robinob/modbus-environment-sensor/manufacturing/BOM.csv

Viide | Komponent | Väärtus/Tüüp | Part number (näide) | Tootja | Kogus | Pakend | Märkused
U4 | Mikrokontroller | STM32G031F8P6 | STM32G031F8P6 | STMicroelectronics | 1 | TSSOP20 | UUS VIIDE (oli U1) - vastavalt 22.09.2026 KiCad-ekspordile. 20-jalaga; gull-wing jalad käsitsi joodetavad (0.65mm samm)
U2 | RS-485 transiiver | 5V half-duplex, autodirection | MAX13487EESA+ | Maxim/Analog Devices | 1 | SOIC-8 | Viide muutumatu (U2). VCC=5V otse U5 buck väljundilt; RE->5V (püsivalt kõrge), SHDN->5V (püsivalt sees); DI<-MCU otse; RO->MCU läbi R24/R25 pingejaoturi (vt allpool, uued viited)
U3 | Temperatuur/niiskusandur (bare kiip, ANDURIPLOKI plaadil) | I2C | SHT45-AD1F-R2 | Sensirion | 1 | DFN-4 | Viide muutumatu (U3). Täpsustatud osanumber KiCad-ekspordist: -R2 (tootja rull/pakendi kood) - sama kiip mis varem, ainult pakendi-suffix täpsustatud; ±1% RH / ±0.2°C
U1 | Õhukvaliteedi andur (eCO2/TVOC, bare kiip, ANDURIPLOKI plaadil) | I2C digitaalne gaasiandur | ENS160-BGLM | ScioSense | 1 | LGA-9 (3x3mm) | UUS VIIDE (oli U4). CSn PEAB olema joodetud otse VDDIO külge (I2C valik); ADDR joodetud GND (0x52) või VDDIO (0x53) külge; INTn jäetakse ühendamata (vt allpool, disabled firmware's), poll DEVICE_STATUS I2C kaudu
U6 | 1.8V LDO (ENS160 VDD, uus tuum-toiteliin) | 1.8V fikseeritud | MCP1700T-1802E/TT | Microchip | 1 | SOT-23-3 | UUS 22.09.2026 - varem KiCad-is nähtud üldnimega 'MCP1700x-180xxTT', täpsustatud tellimiskood. ENS160 VDD (tuum) nõuab rangelt 1.71-1.98V (andmeleht), EI TOHI ühendada otse 3.3V külge - eraldi regulaator 3.3V liinilt. 250mA max, 24mA tüüp./65mA tippkoormus ENS160-l, palju varu. VDDIO jääb 3.3V liinile (mitte sellele 1.8V liinile!) - vt skeem.md ptk 3 parandust I2C pull-up'ide/VDDIO ühenduse kohta
U7 | 5V->3.3V LDO (MCU+andurite peamine 3.3V liin) | 3.3V fikseeritud, keraamiline-stabiilne | TLV70433DBVR | Texas Instruments | 1 | SOT-23-5 | Viide muutumatu (U7). Sisend on U5 5V liin, väljund 3.3V toidab MCU-d ja andureid. NC_A/NC_B jalad (pin1/2) põhjendatult ühendamata - TI kinnitab (E2E foorum), pole sisemiselt ühendatud, võib jätta floating
U5 | Buck-muundur (toide, ainus kõrgepingeline muundamisaste) | 24-30V->5.0V, reguleeritav väljund | MCP16301T-I/CHY | Microchip | 1 | SOT-23-6 | PARANDATUD OSANUMBER 22.09.2026: varem BOM-is kirjas 'MCP16301T-I/OS' - see suffix EI LEIDU üheski distributori andmebaasis (Farnell/DigiKey/Mouser/Octopart) ega tundu reaalne tellitav osa; kasutaja enda KiCad-skeemis on 'MCP16301T-I/CHY', mis ON kinnitatud reaalne osa (DigiKey: 'Buck Switching Regulator IC Positive Adjustable, SOT-23-6') - TÄPSELT see, mida see ahel vajab (reguleeritav väljund, mitte fikseeritud, kuna kasutab välist FB-jagurit R5/R14). Kasuta KiCad-i osanumbrit, mitte varasemat BOM-i oma.
L2 | Buck-muunduri induktor (U5 SW-VOUT vahel) | 22uH, Isat 1.7A, Irms 2A, DCR 64.3mOhm | SLF7055T-220M1R7-3PF | TDK | 1 | 7x7x5.5mm (SLF7055, varjestatud) | UUS VIIDE (oli L1). MCP16301 andmelehe Table 5-1 järgi: VOUT=5.0V -> 22uH; varjestatud (madalam EMI RS-485 lähedal)
D6,D7 | Kaitse-/vabajooksudioodid (sisendi polaarsuskaitse + U5 vabajooksu dioot) | Schottky, >=40V, 0.5-1A | SS34 | Diodes Inc | 2 | SMA | UUED VIIDED (olid D1 ja buck-dioot). KAKS ERALDI funktsiooniga dioodi (sisendi polaarsuskaitse + SW-sõlme vabajooksu dioot), sama osanumber (SS34) sobib mõlemale, üks tellimus kahes asukohas
D8 | Buck-muunduri boost-blokeeriv dioot (VOUT->U5 BOOST jalg) | väike signaaldioot, >=10V, >=100mA | 1N4148 | Nexperia | 1 | SOD-123/DO-35 | UUS VIIDE (oli D3/D4). Anood VÄLJUNDIST (5.0V RAIL), MITTE VIN-ist - vt varasem märkus buck-i valiskomponentide kohta
D2 | ESD/liinikaitse RS-485 liinile | bidirektsionaalne 2-liini TVS, asümmeetriline -7V/+12V | SM712 | Semtech | 1 | SOT-23, 3-jalga | UUS VIIDE (oli U6). RS-485 (EIA-485) standard lubab asümmeetrilist ühisrežiimi vahemikku -7V kuni +12V - SM712 sobib täpselt. Paigalda J5 (bussikonnektor, vt allpool) vahetusse lähedusse enne U2-te
D3 | Olekuindikaator (RGB) | 5mm RGB LED, THT, 4-jalg, hajutatud lääts, common cathode | Kingbright L-154A4SUREQBFZGEW | Kingbright | 1 | THT | UUS VIIDE (oli LED1). KONTROLLI multimeetri dioodi-testiga enne joodmist, ära eelda jalgade järjekorda. R21/R22/R23 (vt allpool) juhivad seda läbi Q1-Q6 kõrgpoolse lülituse (5V liinilt, mitte otse GPIO-lt)
Q1,Q3,Q5 | LED1 kanali nivoonihutaja (NPN, madalpoolne lüliti) - kolm kanalit R/G/B | NPN, 45V/100mA, SOT-23 | BC847 (nt BC847B/C) | Nexperia | 3 | SOT-23 | UUED VIIDED (olid Q1A-Q3A). GPIO -> baasitakisti (10k, vt allpool) -> baas; kollektor = 'sõlm A'; emitter -> GND
Q2,Q4,Q6 | LED1 kanali kõrgpoolne lüliti (PNP) - kolm kanalit R/G/B | PNP, -65V/-100mA, SOT-23 | BC856 (nt BC856B/C) | Nexperia | 3 | SOT-23 | UUED VIIDED (olid Q1B-Q3B). Emitter 5V liinil, baas sõlmel A, kollektor -> piirtakisti -> LED anood. NB: kasutaja KiCad-sümboli 'Datasheet' väli viitab onsemi BC860 dokumendile - see on sümboli metaandmete kõrvalekalle, MITTE tellitav osa; tellimiseks kasuta BC856 (Nexperia), mitte BC860
F2 | Kaitse toitesisendile | resetteeruv kaitse (PTC), Ihold=0.50A/Itrip=1.00A | MF-R050 | Bourns | 1 | radial THT | UUS VIIDE (oli F1). Kaitseb lühise korral bussikaablit ja seadet, paigalduskohas D6/D7 (sisendi dioot) ees
J5 | Bussikonnektor SISSE+VÄLJA (RS-485+toide, daisy-chain, 8-pos loop-through) | 8-pol pluggable header, 90 kraadi, THT, 2.5mm samm | 691382010008 | Wurth Elektronik (WR-TBL 382) | 1 | THT | UUS VIIDE (oli J1). pin1=V+in,2=V+out,3=GNDin,4=GNDout,5=Ain,6=Aout,7=Bin,8=Bout
J1,J6 | I2C kaabli konnektorid (põhiplaat + anduriplokk) - PISTIKUPESA/MALE | 4-pol pluggable header, 90 kraadi, THT, 2.5mm samm | 691382010004 | Wurth Elektronik (WR-TBL 382) | 2 | THT | UUED VIIDED (olid J3, J4). Sama osa mõlemas kohas - üks põhiplaadil (MCU I2C1 juures), teine anduriploki plaadil
J7 | SWD programmeerimispesa | 4-pin 2.54mm | - | - | 1 | THT | UUS VIIDE (oli J2). STLink programmeerimiseks. Osa VEEL VALIMATA (nt Farnellist 4-pin 2.54mm THT header) - anna teada kui tahad, et valin konkreetse Farnell-osa
SW2 | DIP-lüliti Modbus aadressi jaoks | 4-bit DIP switch | - | - | 1 | THT/SMD | UUS VIIDE (oli SW1). Seab slave aadressi 1-16. Osa VEEL VALIMATA - anna teada kui tahad, et valin konkreetse Farnell-osa
R23 | LED1 piirtakisti - PUNANE kanal (5V liinilt, läbi Q2/Q4/Q6 kollektori) | 200 ohm | - | - | 1 | 0805 | UUS VIIDE (oli R15). R=(5V-0.2V-1.9V)/15mA=193R -> 200R (E24), ~14.5mA
R22 | LED1 piirtakisti - ROHELINE kanal | 110 ohm | - | - | 1 | 0805 | UUS VIIDE (oli R16). R=(5V-0.2V-3.2V)/15mA=107R -> 110R (E24), ~13.6mA
R21 | LED1 piirtakisti - SININE kanal | 100 ohm | - | - | 1 | 0805 | UUS VIIDE (oli R17). R=(5V-0.2V-3.3V)/15mA=100R (E24), ~15mA
R18 | RS-485 termineerimine | 120 ohm | - | - | 1 | 0805 | MUUTUNUD: varem R1+R2 (2tk, mõlemad bussi otsad); KiCad-eksport näitab nüüd AINULT 1tk (R18) - kontrolli, kas see on tahtlik (termineeritakse ainult üks ots, tavaline kui see seade ON bussi ots) või puudub teine takisti kogemata. Paigalda ainult bussi lõpp-punkti(desse)
R19,R20 | RS-485 fail-safe biasing (A pullup / B pulldown) | 560 ohm | - | - | 2 | 0805 | UUED VIIDED (olid R3, R4). MAX13487 AutoDirection-mehhanismi jaoks kohustuslikud, mitte valikulised
R24 | RO signaali pingejaotur (ülemine) | 3.3 kohm | - | - | 1 | 0805 | UUS VIIDE (oli R11). U2 RO (5V loogika) -> MCU (3.3V) kaitseks, koos R25-ga
R7,R9,R25 | I2C pull-up takistid + RO pingejaotur (alumine) | 4.7 kohm | - | - | 3 | 0805 | SEGARÜHM - KiCad grupeeris väärtuse järgi: R7+R9 = ENS160 lokaalsed I2C pull-up'id (UUED 22.09.2026, vt skeem.md ptk 3 SCL/SDA ühenduse parandus - need PEAVAD minema 3.3V liinile, MITTE 1.8V U6 väljundile); R25 = RO pingejaotur, alumine pool (oli R12), koos R24-ga (vt eelmine rida)
R14 | U5 FB-jaguri alumine takisti (VFB->GND) | 10 kohm 1% | - | - | 1 | 0805 | Viide muutumatu (R14). 'Good trade-off for quiescent current and noise immunity' (MCP16301 andmeleht)
R5 | U5 FB-jaguri ülemine takisti (VOUT->VFB) | 52.3 kohm 1% | - | - | 1 | 0805 | UUS VIIDE (oli R13). Annab VOUT=4.98V koos R14-ga
R1,R2,R3,R6,R8,R15,R16,R17,R26 | Erinevad 10k pull-up/pull-down asukohad (BOOT0, LED-draiveri baas/pullup, SWCLK) | 10 kohm | - | - | 9 | 0805 | SEGARÜHM - KiCad grupeeris väärtuse järgi, TÄPNE 1:1 viide<->funktsioon pole ekspordist tuletatav (kõik identsed 10k/0805 takistid). Teadaolevad funktsioonid selles rühmas: BOOT0 pull-down (1tk, oli R10), LED1 NPN baasitakistid Q1/Q3/Q5 juures (3tk, olid Rb1-Rb3), LED1 PNP pullup'id sõlmel A (3tk, olid Rpu1-Rpu3), SWCLK pull-down R26 (1tk, uus 22.09.2026, vt skeem.md) = 8 teadaolevat funktsiooni. Rühmas on 9 viidet - KUI sul on plaadil veel üks 10k takisti, mida see loend ei kata, anna teada, mis see on, et saaksin selle eraldi dokumenteerida. Tellimise mõttes pole see probleem (kõik sama väärtus/pakend, üks reamüügiartiklina), ainult dokumentatsiooni jaoks tahaks kõik funktsioonid teada
C1 | MCU bulk-kondensaator (VDD, täiendav ST soovituse kohane) | 1uF keraamiline (X7R) | - | - | 1 | 0603/0805 | UUS 22.09.2026 (KiCad-ekspordis nähtud, polnud varasemas BOM-is) - MADALA KINDLUSEGA oletus: STM32 rakendusnõuded soovitavad tavaliselt 100nF igal VDD-VSS paaril PLUSS üks suurem (1-4.7uF) bulk-kondensaator VDD liinil - see rida vastab tõenäoliselt sellele. Kinnita, kui see on midagi muud
C2 | MCU bypass kondensaator | 100nF | - | - | 1 | 0603 | UUS VIIDE (oli C1/C2 paar, nüüd 1tk - STM32G031F8P6 TSSOP20 paketil tundub olevat vähem VDD-jalgu kui varem eeldatud)
C4 | U2 (RS-485 transiiver) bypass kondensaator | 100nF keraamiline (X7R) | - | - | 1 | 0603 | UUS VIIDE (oli C6). VCC jala juures
C11 | ENS160 (U1) VDD/VDDIO bypass kondensaator | 100nF keraamiline (X7R) | - | - | 1 | 0805 | UUS 22.09.2026, kinnitatud kasutaja skeemi pildilt. Otse U1 VDD/VDDIO jalgade juures
C3 | Buck-muunduri sisendkondensaator (U5 VIN juures) | 10uF keraamiline X7R, >=50V nimipinge | - | - | 1 | 1206 | UUS VIIDE (oli C3/C4 paar, nüüd 1tk nähtaval KiCad-ekspordis) - KONTROLLI: kas buck-il on ka eraldi VÄLJUNDPOOLNE bulk-kondensaator (5V liinil, U5 VOUT juures)? Varasemas disainis oli see kohustuslik (MCP16301 andmeleht nõuab väljundkondensaatorit) - ekspordis ei paista eraldi buck-väljundi kondensaatorit (C5/C14 kuuluvad nüüd U7 sisendile, vt allpool), anna teada kui üks 5V-liini kondensaator on plaanis mujal
C5,C14 | U7 (TLV70433) sisendkondensaatorid (5V liinilt) | 10uF keraamiline X7R | - | - | 2 | 0805 | UUED VIIDED, kinnitatud kasutaja skeemi pildilt (kaks paralleelset 10uF sisendil, lisaks C7 1uF-ile samal sisendil)
C13 | U6 (MCP1700, ENS160 1.8V reg) väljundkondensaator | 10uF keraamiline | - | - | 1 | 0805 | UUS 22.09.2026, kinnitatud kasutaja skeemi pildilt (koos C11 100nF-ga ENS160 VDD/VDDIO juures)
C7 | U7 (TLV70433) sisendkondensaator (lisa, väiksem) | 1uF keraamiline | - | - | 1 | 0805 | UUS 22.09.2026, kinnitatud kasutaja skeemi pildilt (kolmas sisendkondensaator, koos C5/C14 10uF-idega)
C15 | U7 (TLV70433) väljundkondensaator | 1uF keraamiline (X7R) | - | - | 1 | 0805 | UUS VIIDE (oli C9). Vahetult U7 VOUT jala juures; datasheet nõue >=0.47uF
C6 | U6 (MCP1700, ENS160 1.8V reg) sisendkondensaator | 1uF keraamiline | - | - | 1 | 0805 | UUS 22.09.2026 - see on täpselt see kondensaator, mille lisamist soovitasin (VI jala juures puudus varasemas pildis) - hea, et on lisatud
C8 | Buck-muunduri boost-kondensaator (U5 BOOST-SW vahel) | 100nF (0.1uF) keraamiline X7R, >=10V | - | - | 1 | 0603 | OLETUS, KESKMINE KINDLUS (oli C10) - väärtus (0.1uF) ja kogus (1tk) sobivad täpselt buck-i boost-kondensaatori rolliga (MCP16301 andmeleht 5.9 ptk). Kinnita, kui see on midagi muud
C12 | Tuvastamata 10nF kondensaator | 10nF | - | - | 1 | 0805 | TUNDMATU - see väärtus/kogus ei vasta millelegi minu varasemas jälgitud BOM-is. Anna teada, mis funktsioon/asukoht see on, et saaksin selle korrektselt dokumenteerida
Y1 | Kristall (valikuline, kui vaja täpsemat taktsagedust) | 8MHz | - | - | 1 | 3225 | Viide muutumatu, EI ILMU 22.09.2026 KiCad-ekspordis - kas jäeti lõplikult välja (sisemine RC piisab)? Kinnita
- | Anduriploki plaat (2. väike PCB, mouse-bite paneelis põhiplaadiga) | 2-kihiline | - | - | 1 | - | kannab U1 (ENS160) + U3 (SHT45) + U6 (1.8V LDO) + C6/C11/C13 + J1/J6 (üks pistikupesa igal plaadil) - vt skeem.md ptk 9 (mouse bites paneelilahendus)
- | 3D-prinditud korpus | PETG/PLA | - | - | 1 | - | seinapesa raamile sobiv, ventilatsiooniavadega
- | Trükkplaat (PCB) | 2-kihiline | - | - | 1 | - | mõõt vastavalt seinapesa raami sisemõõtudele
