robinob/modbus-environment-sensor/modbus_andur.csv

Reference | Qty | Value | DNP | Exclude from BOM | Exclude from Board | Footprint | Datasheet
C1,C6,C7,C15 | 4 | 1u |  |  |  | Capacitor_SMD:C_0805_2012Metric_Pad1.18x1.45mm_HandSolder | ~
C2,C4,C11 | 3 | 100n |  |  |  | Capacitor_SMD:C_0805_2012Metric_Pad1.18x1.45mm_HandSolder | ~
C3,C5,C13,C14 | 4 | 10u |  |  |  | Capacitor_SMD:C_0805_2012Metric_Pad1.18x1.45mm_HandSolder | ~
C8 | 1 | 0u1 |  |  |  | Capacitor_SMD:C_0805_2012Metric_Pad1.18x1.45mm_HandSolder | ~
C12 | 1 | 10n |  |  |  | Capacitor_SMD:C_0805_2012Metric_Pad1.18x1.45mm_HandSolder | ~
D2 | 1 | SM712 |  |  |  | SM712:SOT23
D3 | 1 | LED_RGBK |  |  |  | LED_THT:LED_D5.0mm-4_RGB_Wide_Pins | ~
D6,D7 | 2 | SS34 |  |  |  | Diode_SMD:D_SMA | https://www.vishay.com/docs/88751/ss32.pdf
D8 | 1 | 1N4148 |  |  |  | Diode_THT:D_DO-35_SOD27_P7.62mm_Horizontal | https://assets.nexperia.com/documents/data-sheet/1N4148_1N4448.pdf
F2 | 1 | MF-R050 |  |  |  | MF-R050:FUSRB510W51L790T310H1370
J1,J6 | 2 | 691382010004 |  |  |  | 691382010004:691382010004
J5 | 1 | 691382010008 |  |  |  | 691382010008:691382010008
J7 | 1 | Conn_01x04_Pin |  |  |  |  | ~
L2 | 1 | 22u / Isat≥1.7A |  |  |  | SLF7055T-220M1R7-3PF:IND_SLF7055T-220M1R7-3PF | ~
Q1,Q3,Q5 | 3 | BC847 |  |  |  | Package_TO_SOT_SMD:SOT-23 | http://www.infineon.com/dgdl/Infineon-BC847SERIES_BC848SERIES_BC849SERIES_BC850SERIES-DS-v01_01-en.pdf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
Q2,Q4,Q6 | 3 | BC856 |  |  |  | Package_TO_SOT_SMD:SOT-23 | https://www.onsemi.com/pub/Collateral/BC860-D.pdf
R1,R2,R3,R6,R8,R14,R15,R16,R17,R26 | 10 | 10k |  |  |  | Resistor_SMD:R_0805_2012Metric_Pad1.20x1.40mm_HandSolder | ~
R5 | 1 | 52k3 |  |  |  | Resistor_SMD:R_0805_2012Metric_Pad1.20x1.40mm_HandSolder | ~
R7,R9,R25 | 3 | 4k7 |  |  |  | Resistor_SMD:R_0805_2012Metric_Pad1.20x1.40mm_HandSolder | ~
R18 | 1 | 120R |  |  |  | Resistor_SMD:R_0805_2012Metric_Pad1.20x1.40mm_HandSolder | ~
R19,R20 | 2 | 560R |  |  |  | Resistor_SMD:R_0805_2012Metric_Pad1.20x1.40mm_HandSolder | ~
R21 | 1 | 100R |  |  |  | Resistor_SMD:R_0805_2012Metric_Pad1.20x1.40mm_HandSolder | ~
R22 | 1 | 110R |  |  |  | Resistor_SMD:R_0805_2012Metric_Pad1.20x1.40mm_HandSolder | ~
R23 | 1 | 200R |  |  |  | Resistor_SMD:R_0805_2012Metric_Pad1.20x1.40mm_HandSolder | ~
R24 | 1 | 3k3 |  |  |  | Resistor_SMD:R_0805_2012Metric_Pad1.20x1.40mm_HandSolder | ~
SW2 | 1 | SW_DIP_x04 |  |  |  |  | ~
U1 | 1 | ENS160-BGLM |  |  |  | ENS160-BGLM:XDCR_ENS160-BGLM
U2 | 1 | max13487eesa+ |  |  |  | 21-0041B_8_MXM | max13487eesa+
U3 | 1 | SHT45-AD1F-R2 |  |  |  | SHT45-AD1F-R2:SHT4X
U4 | 1 | STM32G031F8Px |  |  |  | Package_SO:TSSOP-20_4.4x6.5mm_P0.65mm | https://www.st.com/resource/en/datasheet/stm32g031f8.pdf
U5 | 1 | MCP16301T-I_CHY |  |  |  | MCP16301T-I_CHY:SOT95P270X145-6N
U6 | 1 | MCP1700x-180xxTT |  |  |  | Package_TO_SOT_SMD:SOT-23 | http://ww1.microchip.com/downloads/en/DeviceDoc/20001826D.pdf
U7 | 1 | TLV70433DBVR |  |  |  | TLV70433DBVR:SOT95P280X145-5N
