robinob/modbus-environment-sensor/modbus_andur.kicad_pcb

## KiCad design modbus_andur.kicad_pcb (2026-10-29)

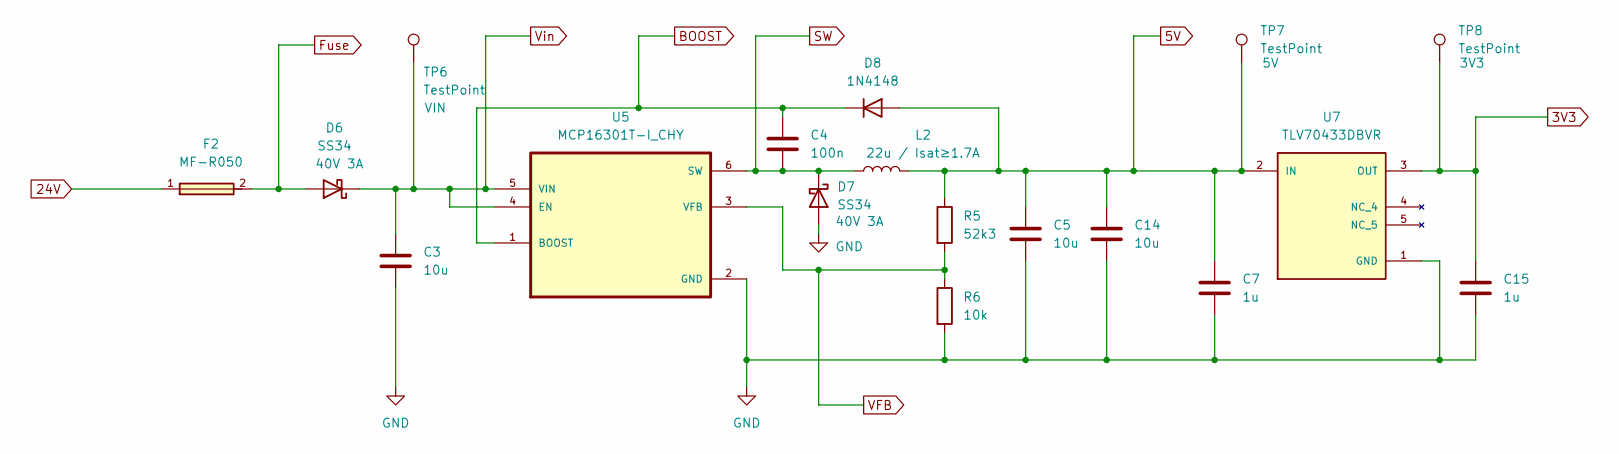
[picture p1: schematic power_supply.kicad_sch, Room Environment Sensor - RS-485/Modbus RTU]

Parts:
C3, C5, C14: 10u; C_0805_2012Metric_Pad1.18x1.45mm_HandSolder
C4: 100n; C_0805_2012Metric_Pad1.18x1.45mm_HandSolder
C7, C15: 1u; C_0805_2012Metric_Pad1.18x1.45mm_HandSolder
D6, D7: SS34; D_SMA
D8: 1N4148; D_DO-35_SOD27_P7.62mm_Horizontal
F2: MF-R050; FUSRB510W51L790T310H1370; MPN MF-R050
L2: 22u / Isat≥1.7A; IND_SLF7055T-220M1R7-3PF
R5: 52k3; R_0805_2012Metric_Pad1.20x1.40mm_HandSolder
R6: 10k; R_0805_2012Metric_Pad1.20x1.40mm_HandSolder
TP6, TP7, TP8: TestPoint; TestPoint_Keystone_5015_Micro_Mini
U5: MCP16301T-I_CHY; SOT95P270X145-6N
U7: TLV70433DBVR; SOT95P280X145-5N; PARTREV D

Connections:
3V3: C15.1, TP8.1, U7.3 (OUT); also elsewhere on the board
5V: C5.1, C7.1, C14.1, D8.2 (A), L2.2, R5.1, TP7.1, U7.2 (IN); also elsewhere on the board
24V: F2.1; also elsewhere on the board
BOOST: C4.1, D8.1 (K), U5.1 (BOOST)
Fuse: D6.2 (A), F2.2
GND: C3.2, C5.2, C7.2, C14.2, C15.2, D7.2 (A), R6.2, U5.2 (GND), U7.1 (GND); also elsewhere on the board
SW: C4.2, D7.1 (K), L2.1, U5.6 (SW)
VFB: R5.2, R6.1, U5.3 (VFB)
Vin: C3.1, D6.1 (K), TP6.1, U5.4 (EN), U5.5 (VIN)

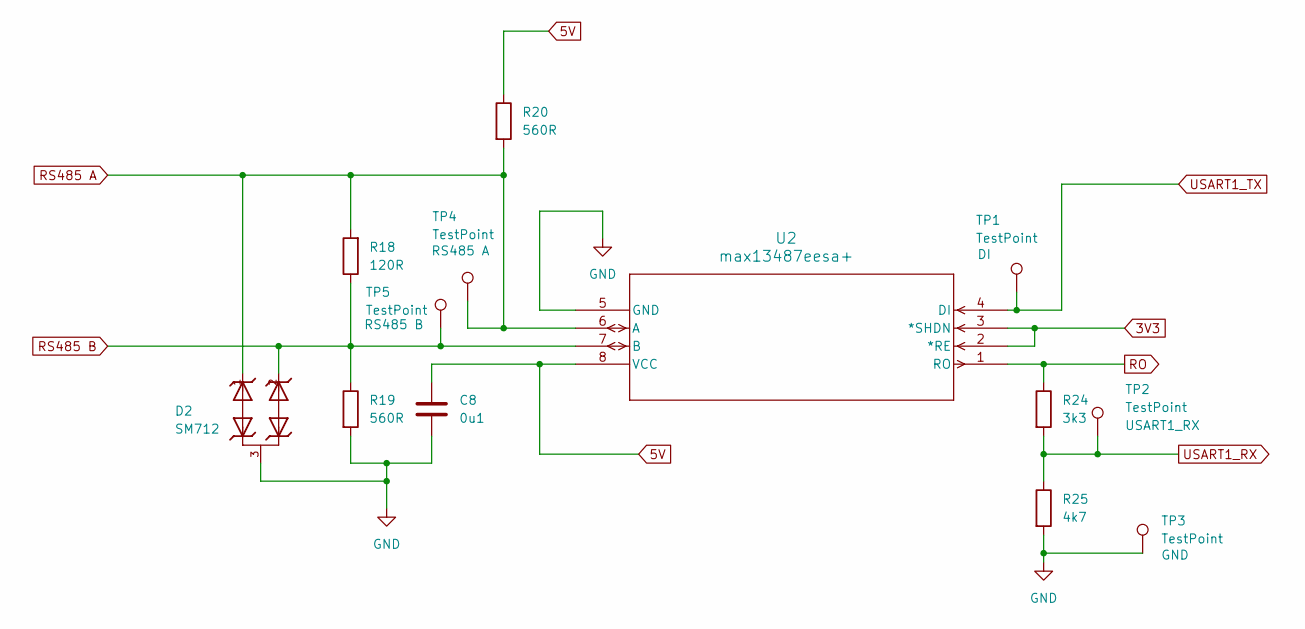
[picture p2: schematic RS_485.kicad_sch, Room Environment Sensor - RS-485/Modbus RTU]

Parts:
C8: 0u1; C_0805_2012Metric_Pad1.18x1.45mm_HandSolder
D2: SM712; SOT23; PART_MANUFACTURER Semtech
R18: 120R; R_0805_2012Metric_Pad1.20x1.40mm_HandSolder
R19, R20: 560R; R_0805_2012Metric_Pad1.20x1.40mm_HandSolder
R24: 3k3; R_0805_2012Metric_Pad1.20x1.40mm_HandSolder
R25: 4k7; R_0805_2012Metric_Pad1.20x1.40mm_HandSolder
TP1, TP2, TP3, TP4, TP5: TestPoint; TestPoint_Keystone_5015_Micro_Mini
U2: max13487eesa+; 21-0041B_8_MXM

Connections:
3V3: U2.2 (*RE), U2.3 (*SHDN); also elsewhere on the board
5V: C8.1, R20.1, U2.8 (VCC); also elsewhere on the board
GND: C8.2, D2.3, R19.2, R25.2, TP3.1, U2.5 (GND); also elsewhere on the board
RO: R24.1, U2.1 (RO)
RS485 A: D2.1, R18.2, R20.2, TP4.1, U2.6 (A); also elsewhere on the board
RS485 B: D2.2, R18.1, R19.1, TP5.1, U2.7 (B); also elsewhere on the board
USART1_RX: R24.2, R25.1, TP2.1; also elsewhere on the board
USART1_TX: TP1.1, U2.4 (DI); also elsewhere on the board

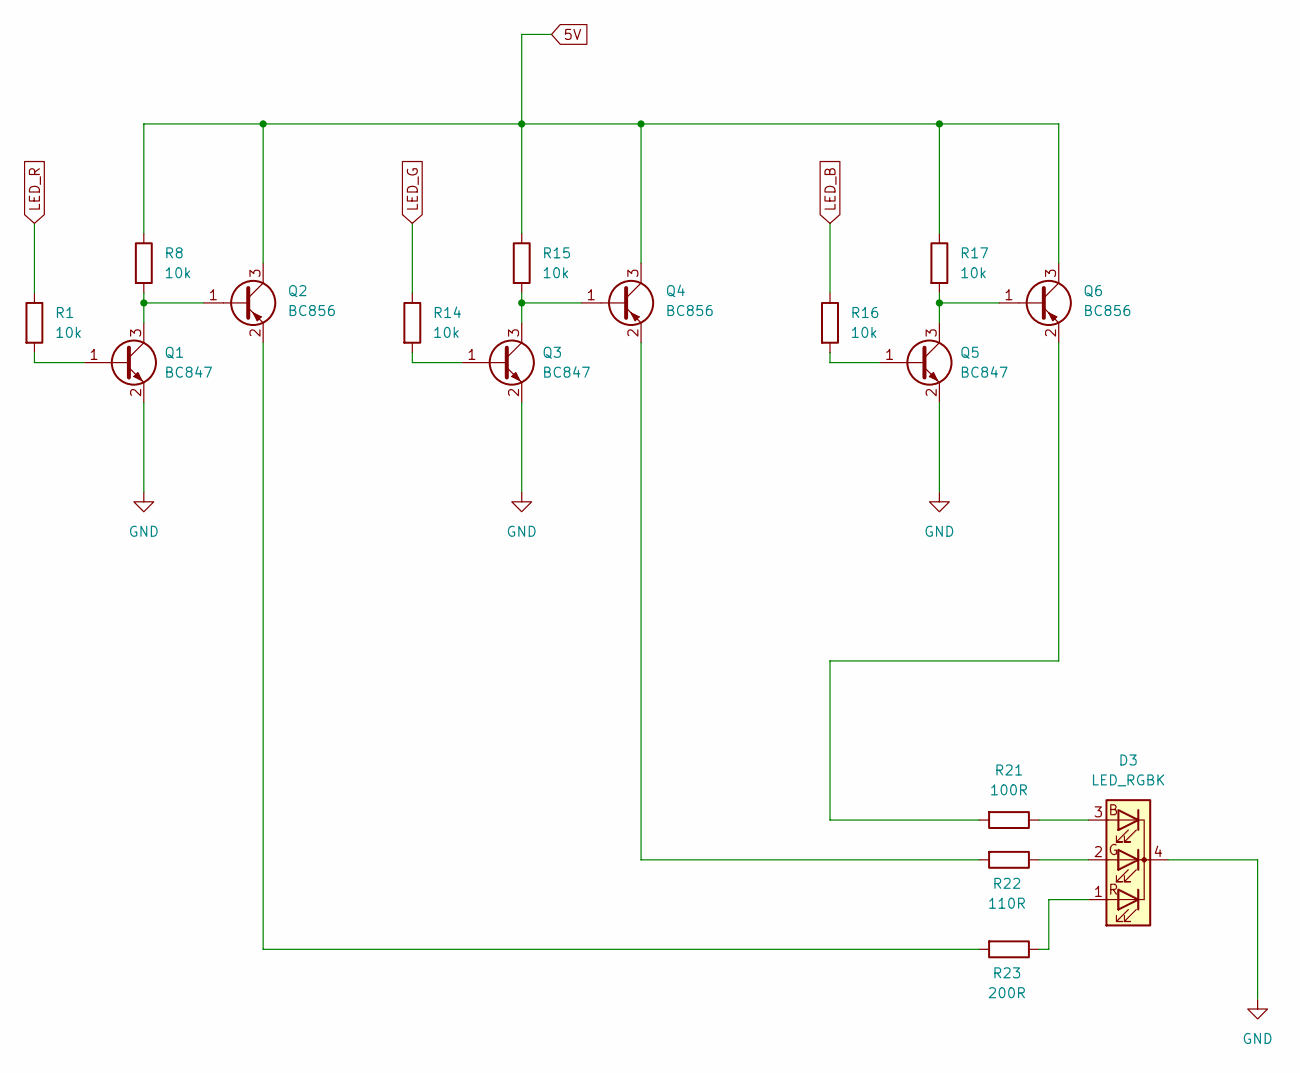
[picture p3: schematic LED.kicad_sch, Room Environment Sensor - RS-485/Modbus RTU]

Parts:
D3: LED_RGBK; LED_D5.0mm-4_RGB_Wide_Pins
Q1, Q3, Q5: BC847; SOT-23
Q2, Q4, Q6: BC856; SOT-23
R1, R8, R14, R15, R16, R17: 10k; R_0805_2012Metric_Pad1.20x1.40mm_HandSolder
R21: 100R; R_0805_2012Metric_Pad1.20x1.40mm_HandSolder
R22: 110R; R_0805_2012Metric_Pad1.20x1.40mm_HandSolder
R23: 200R; R_0805_2012Metric_Pad1.20x1.40mm_HandSolder

Connections:
5V: Q2.3 (C), Q4.3 (C), Q6.3 (C), R8.1, R15.1, R17.1; also elsewhere on the board
GND: D3.4 (K), Q1.2 (E), Q3.2 (E), Q5.2 (E); also elsewhere on the board
LED_B: R16.1; also elsewhere on the board
LED_G: R14.1; also elsewhere on the board
LED_R: R1.1; also elsewhere on the board
unnamed: D3.3 (BA), R21.1
unnamed: D3.2 (GA), R22.1
unnamed: D3.1 (RA), R23.1
unnamed: Q1.1 (B), R1.2
unnamed: Q1.3 (C), Q2.1 (B), R8.2
unnamed: Q2.2 (E), R23.2
unnamed: Q3.1 (B), R14.2
unnamed: Q3.3 (C), Q4.1 (B), R15.2
unnamed: Q4.2 (E), R22.2
unnamed: Q5.1 (B), R16.2
unnamed: Q5.3 (C), Q6.1 (B), R17.2
unnamed: Q6.2 (E), R21.2

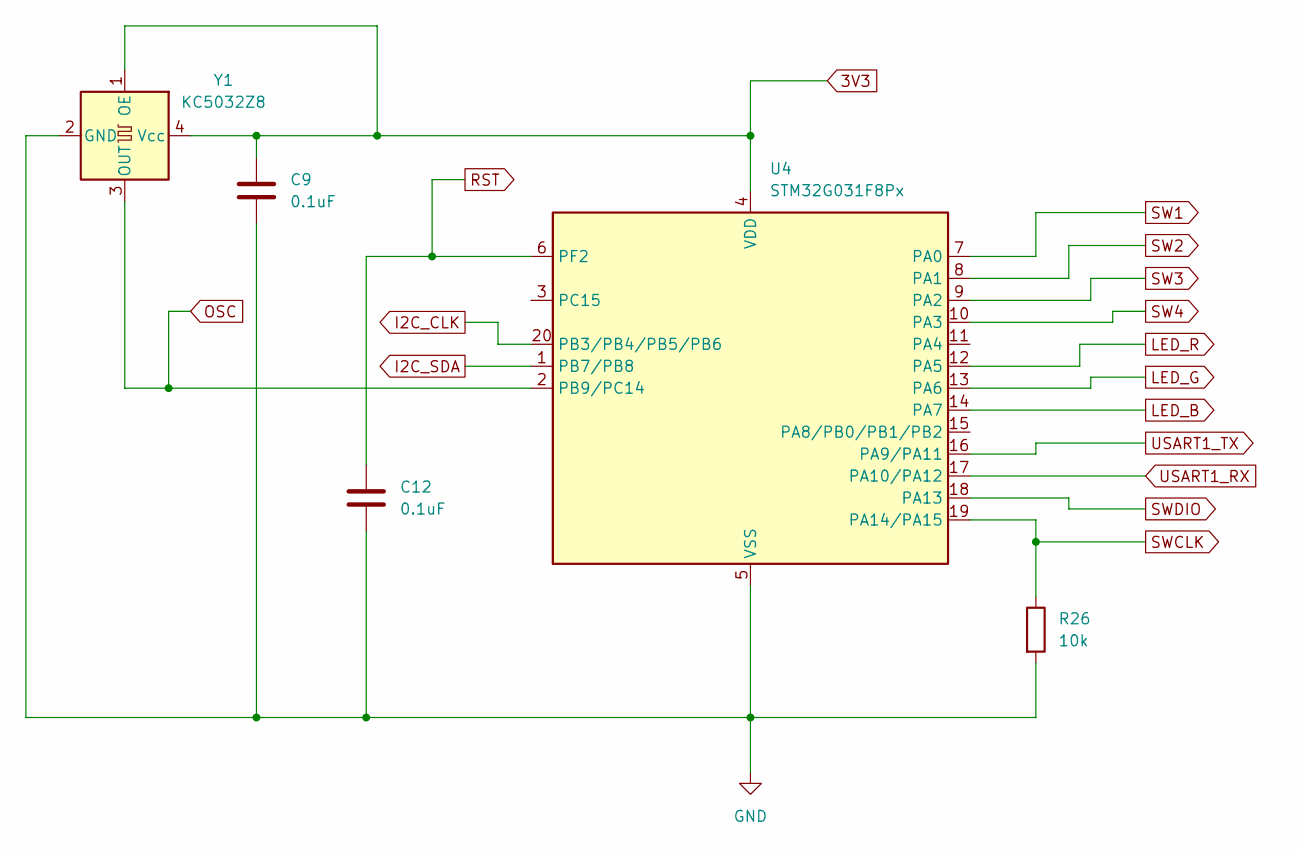
[picture p4: schematic MCU.kicad_sch, Room Environment Sensor - RS-485/Modbus RTU]

Parts:
C9, C12: 0.1uF; C_0805_2012Metric_Pad1.18x1.45mm_HandSolder
R26: 10k; R_0805_2012Metric_Pad1.20x1.40mm_HandSolder
U4: STM32G031F8Px; TSSOP-20_4.4x6.5mm_P0.65mm
Y1: KC5032Z8; Oscillator_SMD_SeikoEpson_SG8002LB-4Pin_5.0x3.2mm_HandSolde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

Connections:
3V3: C9.1, U4.4 (VDD), Y1.1 (OE), Y1.4 (Vcc); also elsewhere on the board
GND: C9.2, C12.2, R26.2, U4.5 (VSS), Y1.2 (GND); also elsewhere on the board
I2C_CLK: U4.20 (PB3/PB4/PB5/PB6); also elsewhere on the board
I2C_SDA: U4.1 (PB7/PB8); also elsewhere on the board
LED_B: U4.14 (PA7); also elsewhere on the board
LED_G: U4.13 (PA6); also elsewhere on the board
LED_R: U4.12 (PA5); also elsewhere on the board
OSC: U4.2 (PB9/PC14), Y1.3 (OUT)
RST: C12.1, U4.6 (PF2)
SW1: U4.7 (PA0); also elsewhere on the board
SW2: U4.8 (PA1); also elsewhere on the board
SW3: U4.9 (PA2); also elsewhere on the board
SW4: U4.10 (PA3); also elsewhere on the board
SWCLK: R26.1, U4.19 (PA14/PA15); also elsewhere on the board
SWDIO: U4.18 (PA13); also elsewhere on the board
USART1_RX: U4.17 (PA10/PA12); also elsewhere on the board
USART1_TX: U4.16 (PA9/PA11); also elsewhere on the board

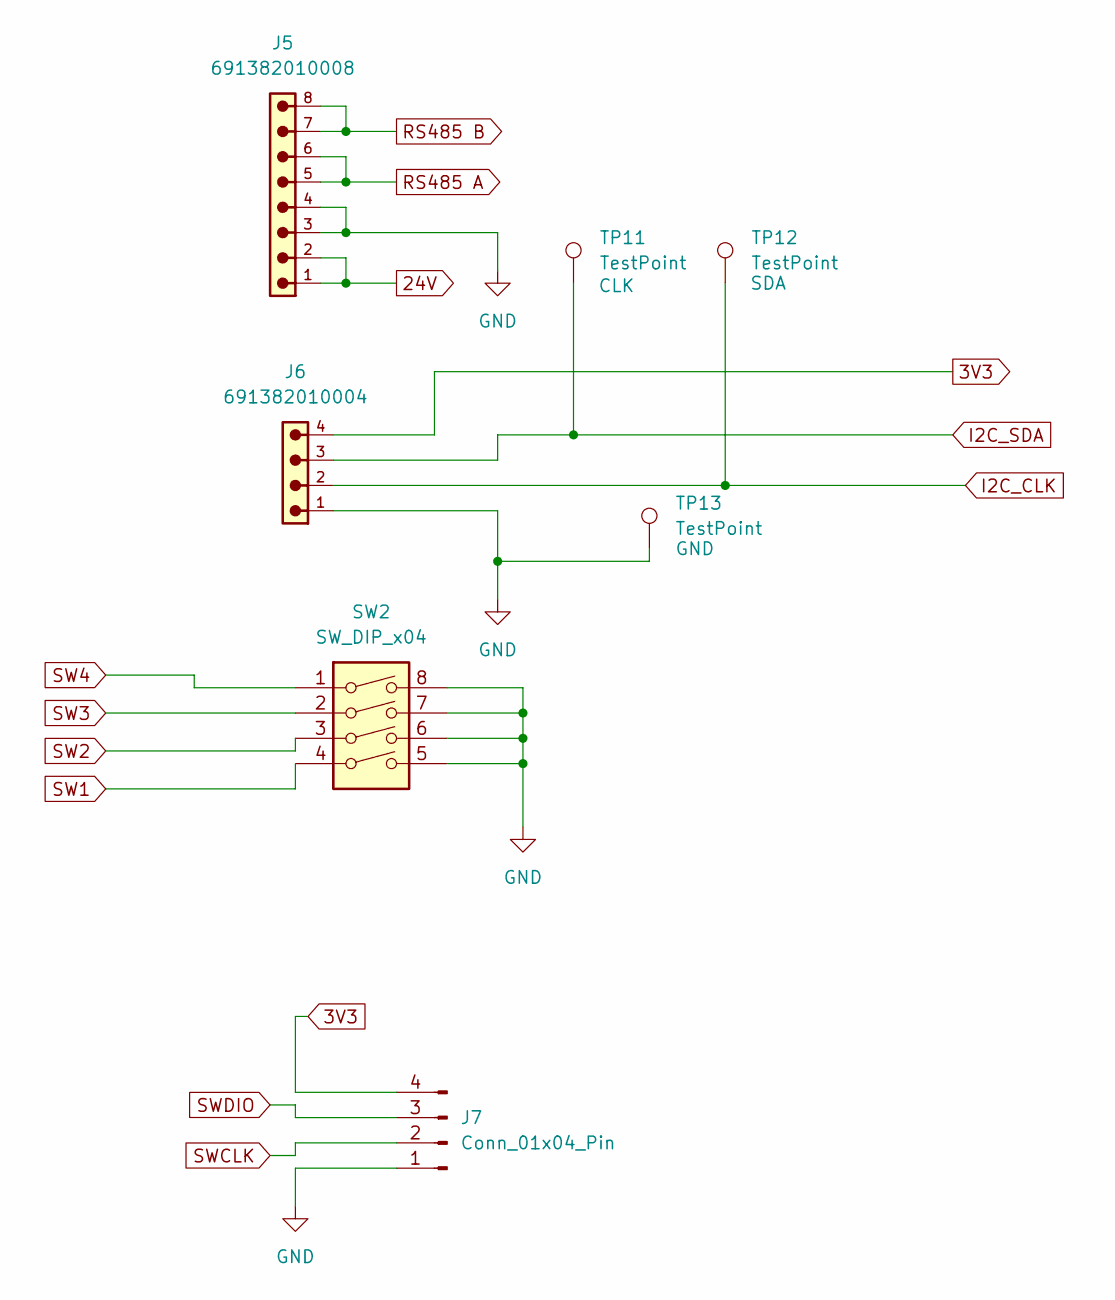
[picture p5: schematic headers.kicad_sch, Room Environment Sensor - RS-485/Modbus RTU]

Parts:
J5: 691382010008
J6: 691382010004
J7: Conn_01x04_Pin; PinHeader_1x04_P2.54mm_Vertical
SW2: SW_DIP_x04; SW_DIP_SPSTx04_Slide_9.78x12.34mm_W7.62mm_P2.54mm
TP11, TP12, TP13: TestPoint; TestPoint_Keystone_5015_Micro_Mini

Connections:
3V3: J6.4, J7.4; also elsewhere on the board
24V: J5.1, J5.2; also elsewhere on the board
GND: J5.3, J5.4, J6.1, J7.1, SW2.5, SW2.6, SW2.7, SW2.8, TP13.1; also elsewhere on the board
I2C_CLK: J6.2, TP12.1; also elsewhere on the board
I2C_SDA: J6.3, TP11.1; also elsewhere on the board
RS485 A: J5.5, J5.6; also elsewhere on the board
RS485 B: J5.7, J5.8; also elsewhere on the board
SW1: SW2.4; also elsewhere on the board
SW2: SW2.3; also elsewhere on the board
SW3: SW2.2; also elsewhere on the board
SW4: SW2.1; also elsewhere on the board
SWCLK: J7.2; also elsewhere on the board
SWDIO: J7.3; also elsewhere on the board

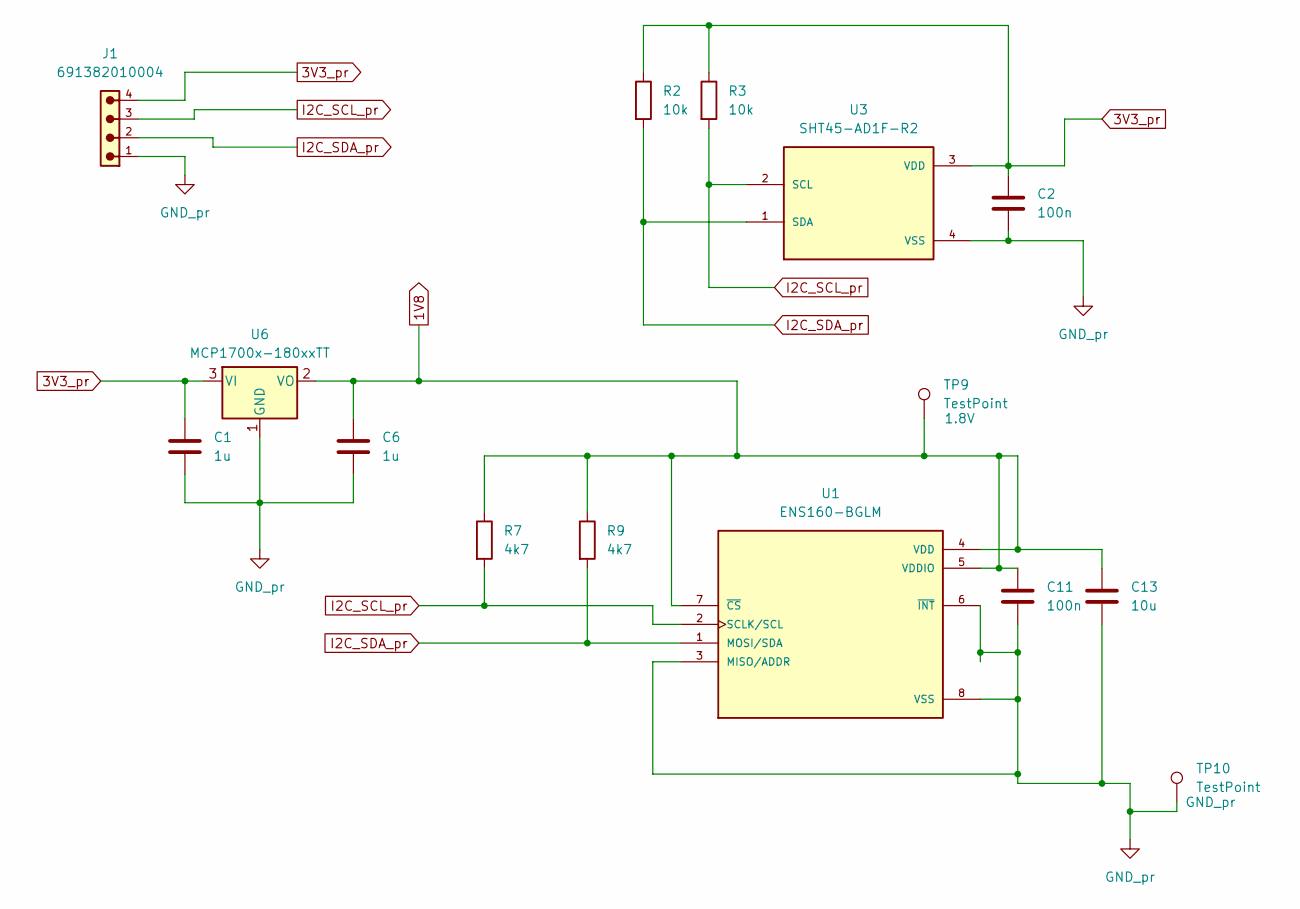
[picture p6: schematic i2c_sensors.kicad_sch, Room Environment Sensor - RS-485/Modbus RTU]

Parts:
C1, C6: 1u; C_0805_2012Metric_Pad1.18x1.45mm_HandSolder
C2, C11: 100n; C_0805_2012Metric_Pad1.18x1.45mm_HandSolder
C13: 10u; C_0805_2012Metric_Pad1.18x1.45mm_HandSolder
J1: 691382010004
R2, R3: 10k; R_0805_2012Metric_Pad1.20x1.40mm_HandSolder
R7, R9: 4k7; R_0805_2012Metric_Pad1.20x1.40mm_HandSolder
TP9, TP10: TestPoint; TestPoint_Keystone_5015_Micro_Mini
U1: ENS160-BGLM; XDCR_ENS160-BGLM; PARTREV 1.3
U3: SHT45-AD1F-R2; SHT4X
U6: MCP1700x-180xxTT; SOT-23

Connections:
1V8: C6.1, C11.1, C13.1, R7.1, R9.1, TP9.1, U1.4 (VDD), U1.5 (VDDIO), U1.7 (~CS), U6.2 (VO)
3V3_pr: C1.1, C2.1, J1.4, R2.1, R3.1, U3.3 (VDD), U6.3 (VI)
GND_pr: C1.2, C2.2, C6.2, C11.2, C13.2, J1.1, TP10.1, U1.3 (MISO/ADDR), U1.6 (~INT), U1.8 (VSS), U1.9 (VSS), U3.4 (VSS), U6.1 (GND)
I2C_SCL_pr: J1.3, R3.2, R7.2, U1.2 (SCLK/SCL), U3.2 (SCL)
I2C_SDA_pr: J1.2, R2.2, R9.2, U1.1 (MOSI/SDA), U3.1 (SDA)

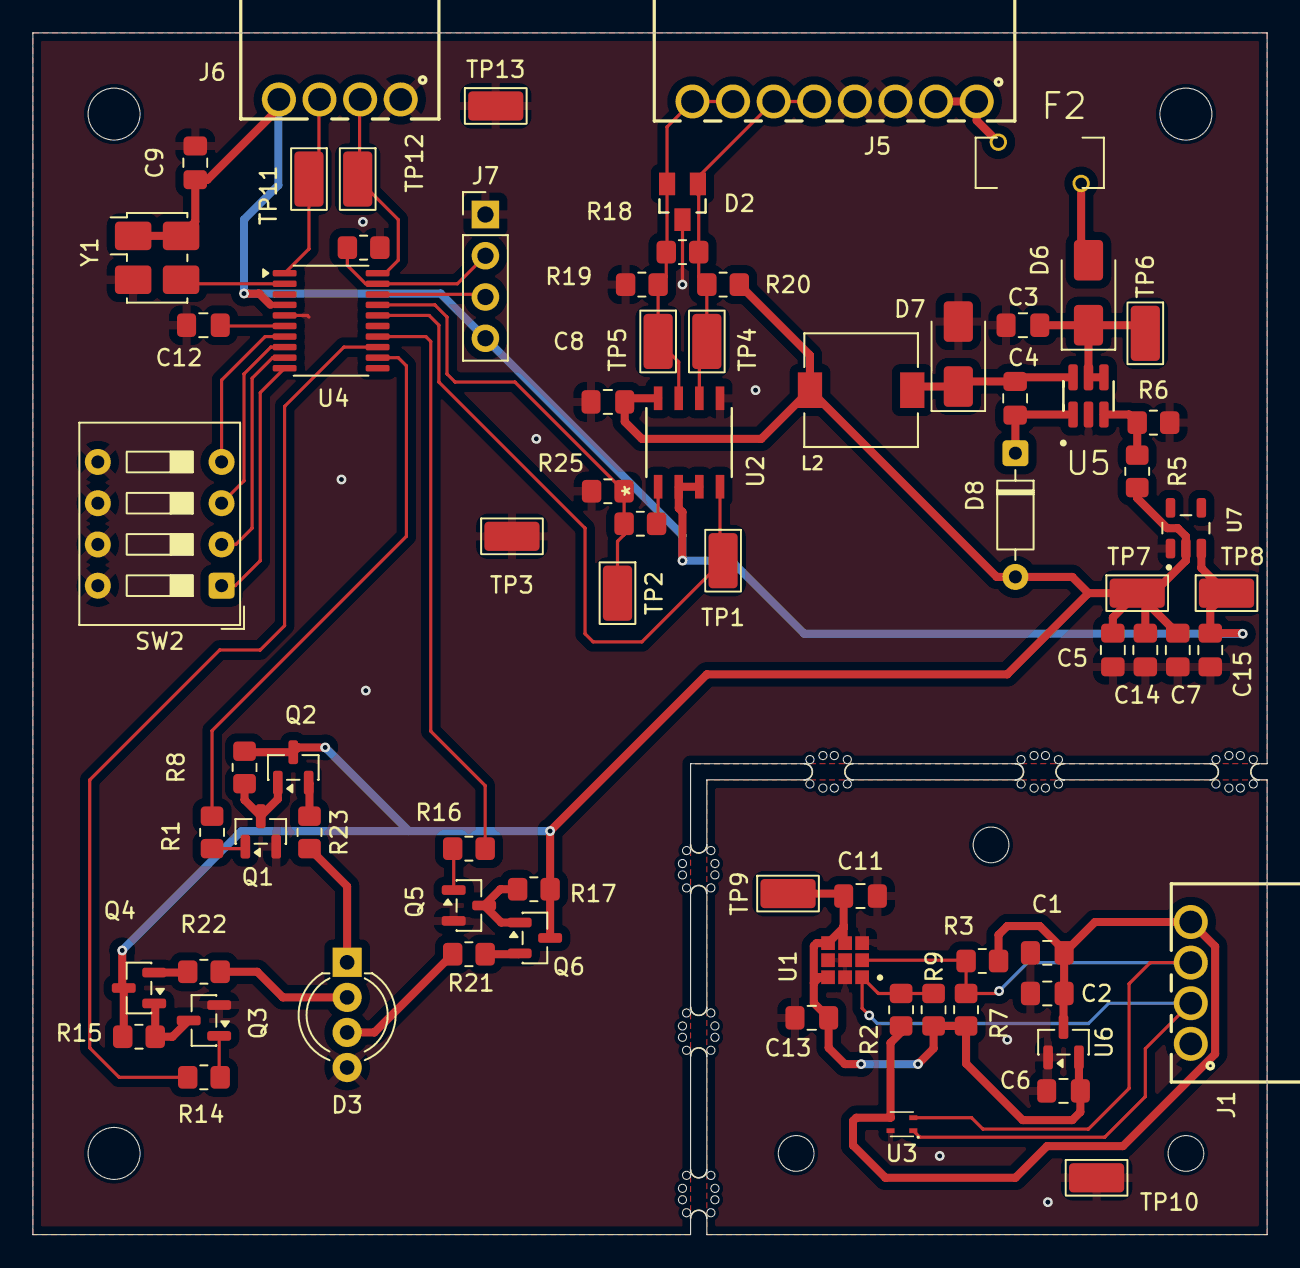
[picture p7: board modbus_andur.kicad_pcb from above]

Board: 2 copper layers, 76.0 x 74.0 mm, 80 parts (0 on the bottom side), 44 nets.

Other parts of the board:
mouse-bite-1mm-slot, mouse-bite-1mm-slot#2, mouse-bite-1mm-slot#3, mouse-bite-1mm-slot#4, mouse-bite-1mm-slot#5, mouse-bite-1mm-slot#6: VAL**; mouse-bite-1mm-slot
