robinob/modbus-environment-sensor/firmware/keskkonnasensor/keskkonnasensor.ioc

Mcu.UserName=STM32G031F8Px
PA0.GPIO_Label=DIP_1
PA0.Signal=GPIO_Input
PA1.GPIO_Label=DIP_2
PA1.Signal=GPIO_Input
PA13.Signal=SYS_SWDIO
PA14-BOOT0.Signal=SYS_SWCLK
PA2.GPIO_Label=DIP_3
PA2.Signal=GPIO_Input
PA3.GPIO_Label=DIP_4
PA3.Signal=GPIO_Input
PA5.GPIO_Label=LED_R
PA5.Signal=GPIO_Output
PA6.GPIO_Label=LED_G
PA6.Signal=GPIO_Output
PA7.GPIO_Label=LED_B
PA7.Signal=GPIO_Output
PB6.Signal=I2C1_SCL
PB7.Signal=I2C1_SDA
