robinob/modbus-environment-sensor/firmware/keskkonnasensor/Core/Inc/main.h

#define DIP_1_Pin GPIO_PIN_0
#define DIP_1_GPIO_Port GPIOA
#define DIP_2_Pin GPIO_PIN_1
#define DIP_2_GPIO_Port GPIOA
#define DIP_3_Pin GPIO_PIN_2
#define DIP_3_GPIO_Port GPIOA
#define DIP_4_Pin GPIO_PIN_3
#define DIP_4_GPIO_Port GPIOA
#define LED_R_Pin GPIO_PIN_5
#define LED_R_GPIO_Port GPIOA
#define LED_G_Pin GPIO_PIN_6
#define LED_G_GPIO_Port GPIOA
#define LED_B_Pin GPIO_PIN_7
#define LED_B_GPIO_Port GPIOA
