robinob/modbus-environment-sensor/(commit log)

2026-10-29 Initial commit: KiCad project, Gerbers, BOM, schematic docs
2026-10-29 Reorganize into manufacturing/ and docs/ folders, add README and BOM
2026-10-30 Enable pull-ups on DIP inputs, add pin labels, document verified pins
2026-11-01 Add Modbus RTU frame parser with PC unit tests
2026-11-01 Add app skeleton with stub drivers, call it from main
2026-11-01 Add interrupt-driven Modbus UART driver, 19200 8E1
